rappet/power-distribution/buslight.kicad_pcb

## KiCad design buslight.kicad_pcb (2023-07-18)

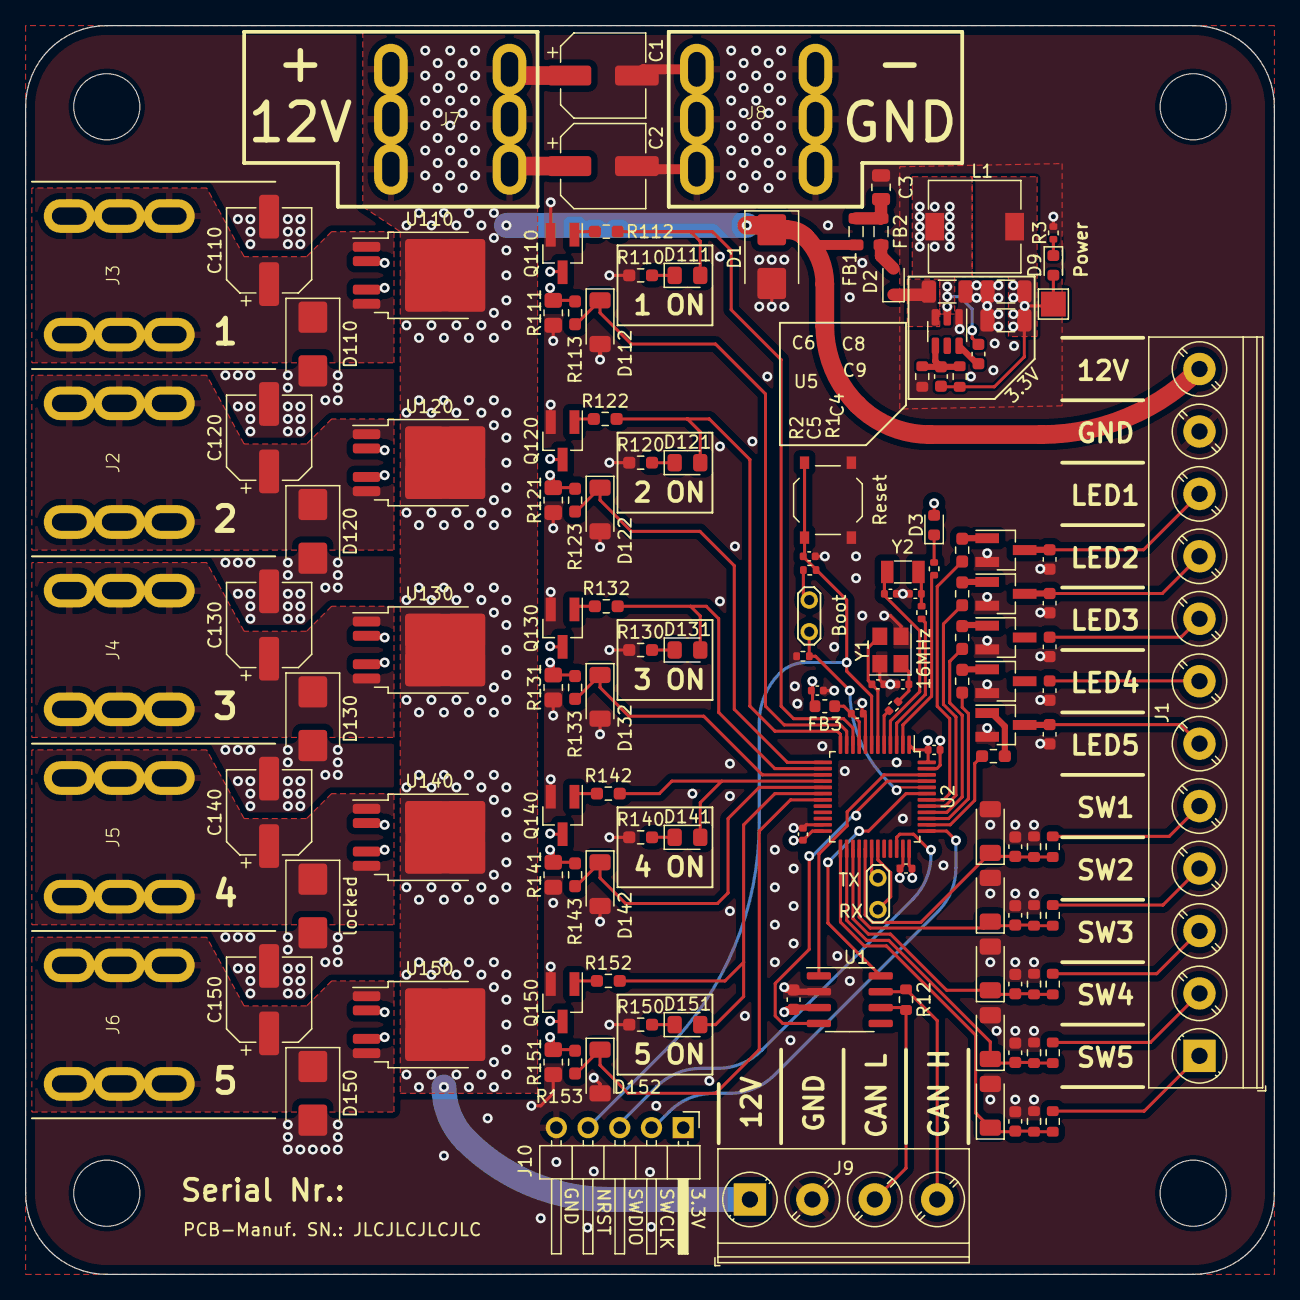
[picture p11: board buslight.kicad_pcb from above]

Board: 4 copper layers, 100.0 x 100.0 mm, 144 parts (0 on the bottom side), 90 nets.

Parts:
C1, C2, C110, C120, C130, C140, C150: 100uF 35V; CP_Elec_6.3x7.7
C3: 100n; C_0805_2012Metric
C4, C7, C20, C21, C22, C23, C24: 100n; C_0603_1608Metric
C5: 47p; C_0603_1608Metric
C6: 10uF; C_1206_3216Metric
C8, C9: 47u; C_1206_3216Metric
C10, C11, C12, C13, C14, C19: 100n; C_0402_1005Metric
C15, C16: 10p; C_0402_1005Metric
C17, C18: 18p; C_0402_1005Metric
C25, C26, C27, C28, C29: 1u 50V; C_0603_1608Metric
D1, D110, D120, D130, D150: SMBJ30CA; D_SMB
D2: 1N5819WS; D_SOD-323
D3, D9: RED; LED_0603_1608Metric
D20, D21, D22, D23, D24, D112, D122, D132, D142, D152: ZMM3V3-M; D_MiniMELF
D111, D121, D131, D141, D151: LED; LED_0805_2012Metric_Pad1.15x1.40mm_HandSolder
FB1, FB2: 100Ω@100MHz; L_0805_2012Metric
FB3: 600Ω@100MHz; L_0603_1608Metric
H1, H2, H3, H4: MountingHole; MountingHole_5.3mm_M5_ISO7380
J1: Screw_Terminal_01x12; TerminalBlock_Phoenix_PT-1,5-12-5.0-H_1x12_P5.00mm_Horizont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
J2, J3, J4, J5, J6, J7, J8: Screw_Terminal_01x01; T46004
J9: Screw_Terminal_01x04; TerminalBlock_Phoenix_PT-1,5-4-5.0-H_1x04_P5.00mm_Horizontal
J10: Conn_01x05_Pin; PinHeader_1x05_P2.54mm_Horizontal
L1: 10uH 39.6mΩ; L_7.3x7.3_H4.5
Q1, Q2, Q3, Q4, Q5, Q110, Q120, Q130, Q140, Q150: MMBT3904; SOT-23_Handsoldering
R1: 100k; R_0603_1608Metric
R2: 22k; R_0603_1608Metric
R3: 1kR; R_0402_1005Metric
R4, R6: 1k; R_0402_1005Metric
R10, R11: 0R; R_0402_1005Metric
R12: 120R; R_0603_1608Metric
R13: 10k; R_0402_1005Metric
R20, R21, R22, R23, R24, R110, R112, R113, R120, R122, R123, R130, R132, R133, R140, R142, R143, R150, R152, R153: 1k; R_0603_1608Metric_Pad0.98x0.95mm_HandSolder
R25, R26, R27, R28, R29: 3.3k; R_0603_1608Metric
R30, R31, R32, R33, R34: 1k; R_0603_1608Metric
R111, R121, R131, R141, R151: 220; R_0805_2012Metric_Pad1.20x1.40mm_HandSolder
SW2: Reset; SW_Push_1P1T_XKB_TS-1187A
TP1: TestPoint; TestPoint_Pad_2.0x2.0mm
TP2: UART; TestPoint_2Pads_Pitch2.54mm_Drill0.8mm
TP3: Boot0; TestPoint_2Pads_Pitch2.54mm_Drill0.8mm
U1: SN65HVD230; SOIC-8_3.9x4.9mm_P1.27mm
U2: STM32F103C8T6; LQFP-48_7x7mm_P0.5mm
U5: TPS54202; SOT-23-6
U110, U120, U130, U140, U150: BTS6143D; TO-252-4
Y1: 16MHz 9pF; Crystal_SMD_3225-4Pin_3.2x2.5mm
Y2: 32.768kHz 12.5pF; Crystal_SMD_3215-2Pin_3.2x1.5mm
locked: SMBJ30CA; D_SMB

Connections:
+3.3V: C5.2, C7.2, C8.1, C9.1, C10.1, C11.1, C12.1, C14.1, D3.2 (A), D9.2 (A), FB3.2, J10.1, L1.2, R1.1, R4.1, TP1.1, TP3.1, U1.3 (VCC), U2.1 (VBAT), U2.24 (VDD), U2.36 (VDD), U2.48 (VDD)
+12V: C6.1, D2.1 (K), U5.3 (VIN)
+BATT: C1.1, C2.1, D1.1 (A1), FB1.1, J1.12, J7.1, J9.1, U110.3 (Vbb), U120.3 (Vbb), U130.3 (Vbb), U140.3 (Vbb), U150.3 (Vbb)
/Control/BOOT0: R13.2, TP3.2, U2.44 (BOOT0)
/Control/CAN_H: J9.4, R12.1, U1.7 (CANH)
/Control/CAN_L: J9.3, R12.2, U1.6 (CANL)
/Control/CAN_RX: U1.4 (R), U2.45 (PB8)
/Control/CAN_Rs: U1.8 (Rs), U2.43 (PB7)
/Control/CAN_TX: U1.1 (D), U2.46 (PB9)
/Control/LED: R6.2, U2.2 (PC13)
/Control/NRST: C19.1, J10.4, R4.2, SW2.2, U2.7 (NRST)
/Control/OSC32_IN: R11.2, U2.3 (PC14)
/Control/OSC32_OUT: C18.1, U2.4 (PC15), Y2.2
/Control/OSC_IN: R10.2, U2.5 (PD0)
/Control/OSC_OUT: C16.1, U2.6 (PD1), Y1.3
/Control/SWCLK: J10.2, U2.37 (PA14)
/Control/SWDIO: J10.3, U2.34 (PA13)
/IO Ports/LED_1_Conn: C20.1, J1.10, Q1.3 (C)
/IO Ports/LED_2_Conn: C21.2, J1.9, Q2.3 (C)
/IO Ports/LED_3_Conn: C22.2, J1.8, Q3.3 (C)
/IO Ports/LED_4_Conn: C23.2, J1.7, Q4.3 (C)
/IO Ports/LED_5_Conn: C24.2, J1.6, Q5.3 (C)
/IO Ports/SW_1_Conn: J1.5, R30.2
/IO Ports/SW_2_Conn: J1.4, R31.2
/IO Ports/SW_3_Conn: J1.3, R32.2
/IO Ports/SW_4_Conn: J1.2, R33.2
/IO Ports/SW_5_Conn: J1.1, R34.2
/Power supply/BOOT_3.3: C4.1, U5.6 (BOOT)
/Power supply/FB_3.3: C5.1, R1.2, R2.1, U5.4 (FB)
/Power supply/SW_3.3: C4.2, L1.1, U5.2 (SW)
/Switch 1/IN_Inverted: Q110.3 (C), U110.2 (IN)
/Switch 1/OUT: C110.1, D110.1 (A1), J3.1, U110.1 (OUT), U110.5 (OUT)
/Switch 2/IN_Inverted: Q120.3 (C), U120.2 (IN)
/Switch 2/OUT: C120.1, D120.1 (A1), J2.1, U120.1 (OUT), U120.5 (OUT)
/Switch 3/IN_Inverted: Q130.3 (C), U130.2 (IN)
/Switch 3/OUT: C130.1, D130.1 (A1), J4.1, U130.1 (OUT), U130.5 (OUT)
/Switch 4/IN_Inverted: Q140.3 (C), U140.2 (IN)
/Switch 4/OUT: C140.1, J5.1, U140.1 (OUT), U140.5 (OUT), locked.1 (A1)
/Switch 5/IN_Inverted: Q150.3 (C), U150.2 (IN)
/Switch 5/OUT: C150.1, D150.1 (A1), J6.1, U150.1 (OUT), U150.5 (OUT)
EN_1: D111.2 (A), R112.2, U2.10 (PA0)
EN_2: D121.2 (A), R122.2, U2.12 (PA2)
EN_3: D131.2 (A), R132.2, U2.14 (PA4)
EN_4: D141.2 (A), R142.2, U2.16 (PA6)
EN_5: D151.2 (A), R152.2, U2.18 (PB0)
GND: C1.2, C2.2, C3.2, C6.2, C7.1, C8.2, C9.2, C10.2, C11.2, C12.2, C13.2, C14.2, C15.2, C16.2, C17.2, C18.2, C19.2, C20.2, C21.1, C22.1, C23.1, C24.1, C25.2, C26.2, C27.2, C28.2, C29.2, C110.2, C120.2, C130.2, C140.2, C150.2, D1.2 (A2), D20.2 (A), D21.2 (A), D22.2 (A), D23.2 (A), D24.2 (A), D110.2 (A2), D112.2 (A), D120.2 (A2), D122.2 (A), D130.2 (A2), D132.2 (A), D142.2 (A), D150.2 (A2), D152.2 (A), J1.11, J8.1, J9.2, J10.5, Q1.2 (E), Q2.2 (E), Q3.2 (E), Q4.2 (E), Q5.2 (E), Q110.2 (E), Q120.2 (E), Q130.2 (E), Q140.2 (E), Q150.2 (E), R2.2, R3.2, R13.1, R25.2, R26.2, R27.2, R28.2, R29.2, R110.1, R111.2, R120.1, R121.2, R130.1, R131.2, R140.1, R141.2, R150.1, R151.2, SW2.1, U1.2 (GND), U2.8 (VSSA), U2.23 (VSS), U2.35 (VSS), U2.47 (VSS), U5.1 (GND), Y1.2, Y1.4, locked.2 (A2)
LED_1: R20.2, U2.42 (PB6)
LED_2: R21.2, U2.41 (PB5)
LED_3: R22.2, U2.40 (PB4)
LED_4: R23.2, U2.39 (PB3)
LED_5: R24.2, U2.38 (PA15)
unnamed: C3.1, FB1.2, FB2.1
unnamed: C15.1, R10.1, Y1.1
unnamed: C17.1, R11.1, Y2.1
unnamed: D2.2 (A), FB2.2
unnamed: D3.1 (K), R6.1
unnamed: D9.1 (K), R3.1
unnamed: D111.1 (K), R110.2
unnamed: D121.1 (K), R120.2
unnamed: D131.1 (K), R130.2
unnamed: D141.1 (K), R140.2
unnamed: D151.1 (K), R150.2
unnamed: Q1.1 (B), R20.1
unnamed: Q2.1 (B), R21.1
unnamed: Q3.1 (B), R22.1
unnamed: Q4.1 (B), R23.1
unnamed: Q5.1 (B), R24.1
unnamed: Q110.1 (B), R112.1
unnamed: Q120.1 (B), R122.1
unnamed: Q130.1 (B), R132.1
unnamed: Q140.1 (B), R142.1
unnamed: Q150.1 (B), R152.1
unnamed: R111.1, R113.1, U110.4 (IS)
unnamed: R121.1, R123.1, U120.4 (IS)
unnamed: R131.1, R133.1, U130.4 (IS)
unnamed: R141.1, R143.1, U140.4 (IS)
unnamed: R151.1, R153.1, U150.4 (IS)
RX: TP2.2, U2.31 (PA10)
SW_1: C25.1, D20.1 (K), R25.1, R30.1, U2.29 (PA8)
SW_2: C26.1, D21.1 (K), R26.1, R31.1, U2.28 (PB15)
SW_3: C27.1, D22.1 (K), R27.1, R32.1, U2.27 (PB14)
SW_4: C28.1, D23.1 (K), R28.1, R33.1, U2.26 (PB13)
SW_5: C29.1, D24.1 (K), R29.1, R34.1, U2.25 (PB12)
Sense_1: D112.1 (K), R113.2, U2.11 (PA1)
Sense_2: D122.1 (K), R123.2, U2.13 (PA3)
Sense_3: D132.1 (K), R133.2, U2.15 (PA5)
Sense_4: D142.1 (K), R143.2, U2.17 (PA7)
Sense_5: D152.1 (K), R153.2, U2.19 (PB1)
TX: TP2.1, U2.30 (PA9)
VDDA: C13.1, FB3.1, U2.9 (VDDA)
