rappet/power-distribution/(commit log)

2023-07-17 Finalizing initial design
    [buslight-B_Cu.gbr, buslight-B_Mask.gbr, buslight-B_Paste.gbr, buslight-B_Silkscreen.gbr, buslight-Edge_Cuts.gbr, buslight-F_Cu.gbr, buslight-F_Mask.gbr, buslight-F_Paste.gbr]
2023-07-18 Final touches
    [buslight-B_Cu.gbr, buslight-B_Mask.gbr, buslight-B_Paste.gbr, buslight-B_Silkscreen.gbr, buslight-Edge_Cuts.gbr, buslight-F_Cu.gbr, buslight-F_Mask.gbr, buslight-F_Paste.gbr]
